plietar/solar-panel-monitor/hardware/power-monitor.kicad_pcb

## KiCad design hardware/power-monitor.kicad_pcb (2024-04-21)

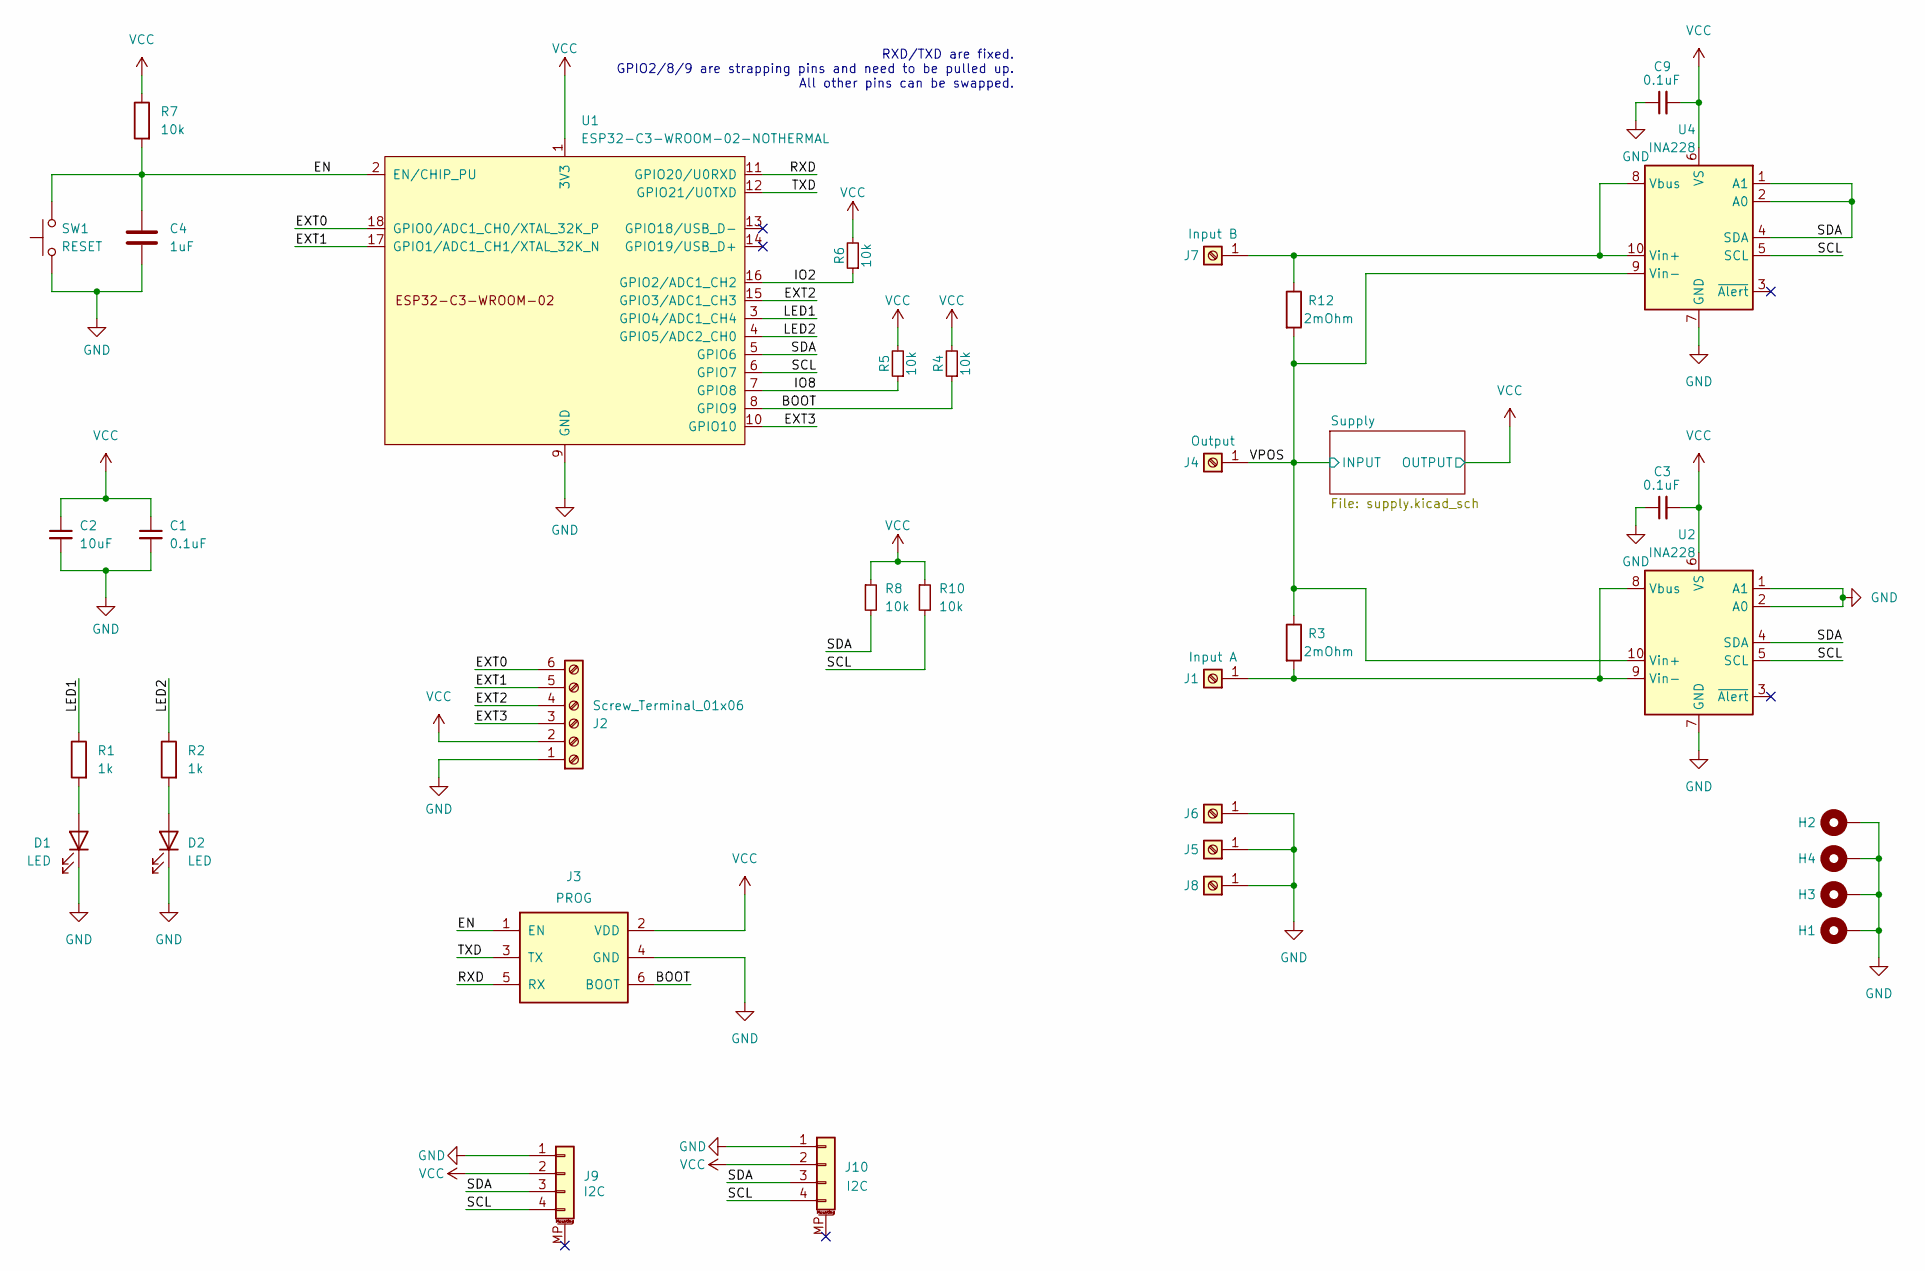
[picture p1: schematic power-monitor.kicad_sch]

Parts:
C1: 0.1uF; C_1206_3216Metric_Pad1.33x1.80mm_HandSolder
C2: 10uF; C_1206_3216Metric_Pad1.33x1.80mm_HandSolder
C3, C9: 0.1uF; C_0603_1608Metric_Pad1.08x0.95mm_HandSolder
C4: 1uF; C_1206_3216Metric_Pad1.33x1.80mm_HandSolder
D1, D2: LED; LED_1206_3216Metric_Pad1.42x1.75mm_HandSolder
H1, H2, H3, H4: MountingHole_Pad; MountingHole_2.2mm_M2_Pad
J1, J4, J5, J6, J7, J8: Wuerth_REDCUBE-THR_WP-THRSH_74651175_THR
J2: Screw_Terminal_01x06; TerminalBlock_Phoenix_MPT-0,5-6-2.54_1x06_P2.54mm_Horizontal
J3: Tag-Connect_TC2030-IDC-NL_2x03_P1.27mm_Vertical
J9: JST_PH_S4B-PH-SM4-TB_1x04-1MP_P2.00mm_Horizontal
J10: JST_SH_SM04B-SRSS-TB_1x04-1MP_P1.00mm_Horizontal
R1, R2: 1k; R_1206_3216Metric_Pad1.30x1.75mm_HandSolder
R3, R12: 2mOhm; R_2816_7142Metric_Pad3.20x4.45mm_HandSolder
R4, R5, R6, R7, R8, R10: 10k; R_1206_3216Metric_Pad1.30x1.75mm_HandSolder
SW1: RESET; SW_Push_1P1T_NO_6x6mm_H9.5mm
U1: ESP32-C3-WROOM-02-NOTHERMAL
U2, U4: INA228; VSSOP-10_3x3mm_P0.5mm

Connections:
/BOOT: J3.6 (BOOT), R4.1, U1.8 (GPIO9)
/EN: C4.1, J3.1 (EN), R7.2, SW1.1, U1.2 (EN/CHIP_PU)
/EXT0: J2.6, U1.18 (GPIO0/ADC1_CH0/XTAL_32K_P)
/EXT1: J2.5, U1.17 (GPIO1/ADC1_CH1/XTAL_32K_N)
/EXT2: J2.4, U1.15 (GPIO3/ADC1_CH3)
/EXT3: J2.3, U1.10 (GPIO10)
/IO2: R6.1, U1.16 (GPIO2/ADC1_CH2)
/IO8: R5.1, U1.7 (GPIO8)
/LED1: R1.1, U1.3 (GPIO4/ADC1_CH4)
/LED2: R2.1, U1.4 (GPIO5/ADC2_CH0)
/RXD: J3.5 (RX), U1.11 (GPIO20/U0RXD)
/SCL: J9.4, J10.4, R10.2, U1.6 (GPIO7), U2.5 (SCL), U4.5 (SCL)
/SDA: J9.3, J10.3, R8.2, U1.5 (GPIO6), U2.4 (SDA), U4.1 (A1), U4.2 (A0), U4.4 (SDA)
/TXD: J3.3 (TX), U1.12 (GPIO21/U0TXD)
/VPOS: J4.1, R3.1, R12.2, U2.10 (Vin+), U4.9 (Vin-); also elsewhere on the board
GND: C1.2, C2.2, C3.1, C4.2, C9.1, D1.1 (K), D2.1 (K), H1.1, H2.1, H3.1, H4.1, J2.1, J3.4 (GND), J5.1, J6.1, J8.1, J9.1, J10.1, SW1.2, U1.9 (GND), U2.1 (A1), U2.2 (A0), U2.7 (GND), U4.7 (GND); also elsewhere on the board
unnamed: D1.2 (A), R1.2
unnamed: D2.2 (A), R2.2
unnamed: J1.1, R3.2, U2.8 (Vbus), U2.9 (Vin-)
unnamed: J7.1, R12.1, U4.8 (Vbus), U4.10 (Vin+)
VCC: C1.1, C2.1, C3.2, C9.2, J2.2, J3.2 (VDD), J9.2, J10.2, R4.2, R5.2, R6.2, R7.1, R8.1, R10.1, U1.1 (3V3), U2.6 (VS), U4.6 (VS); also elsewhere on the board

Notes on the sheet:
RXD/TXD are fixed. GPIO2/8/9 are strapping pins and need to be pulled up. All other pins can be swapped.

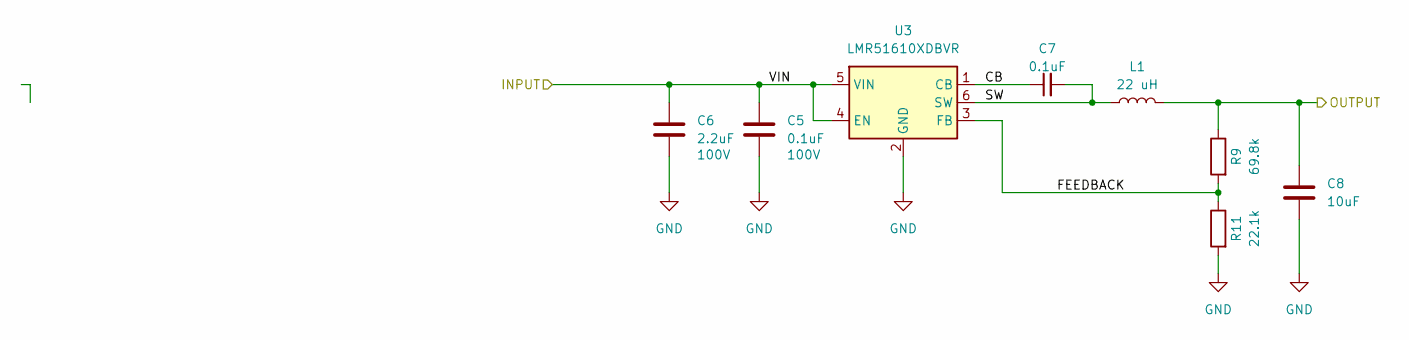
[picture p2: schematic supply.kicad_sch]

Parts:
C5, C7: 0.1uF; C_0603_1608Metric_Pad1.08x0.95mm_HandSolder
C6: 2.2uF; C_1206_3216Metric_Pad1.33x1.80mm_HandSolder
C8: 10uF; C_1206_3216Metric_Pad1.33x1.80mm_HandSolder
L1: 22 uH; L_Bourns_SRN6045TA
R9: 69.8k; R_1206_3216Metric_Pad1.30x1.75mm_HandSolder
R11: 22.1k; R_1206_3216Metric_Pad1.30x1.75mm_HandSolder
U3: LMR51610XDBVR; SOT-23-6

Connections:
/Supply/CB: C7.1, U3.1 (CB)
/Supply/FEEDBACK: R9.2, R11.1, U3.3 (FB)
/Supply/SW: C7.2, L1.1, U3.6 (SW)
/VPOS: C5.1, C6.1, U3.4 (EN), U3.5 (VIN); also elsewhere on the board
GND: C5.2, C6.2, C8.2, R11.2, U3.2 (GND); also elsewhere on the board
VCC: C8.1, L1.2, R9.1; also elsewhere on the board

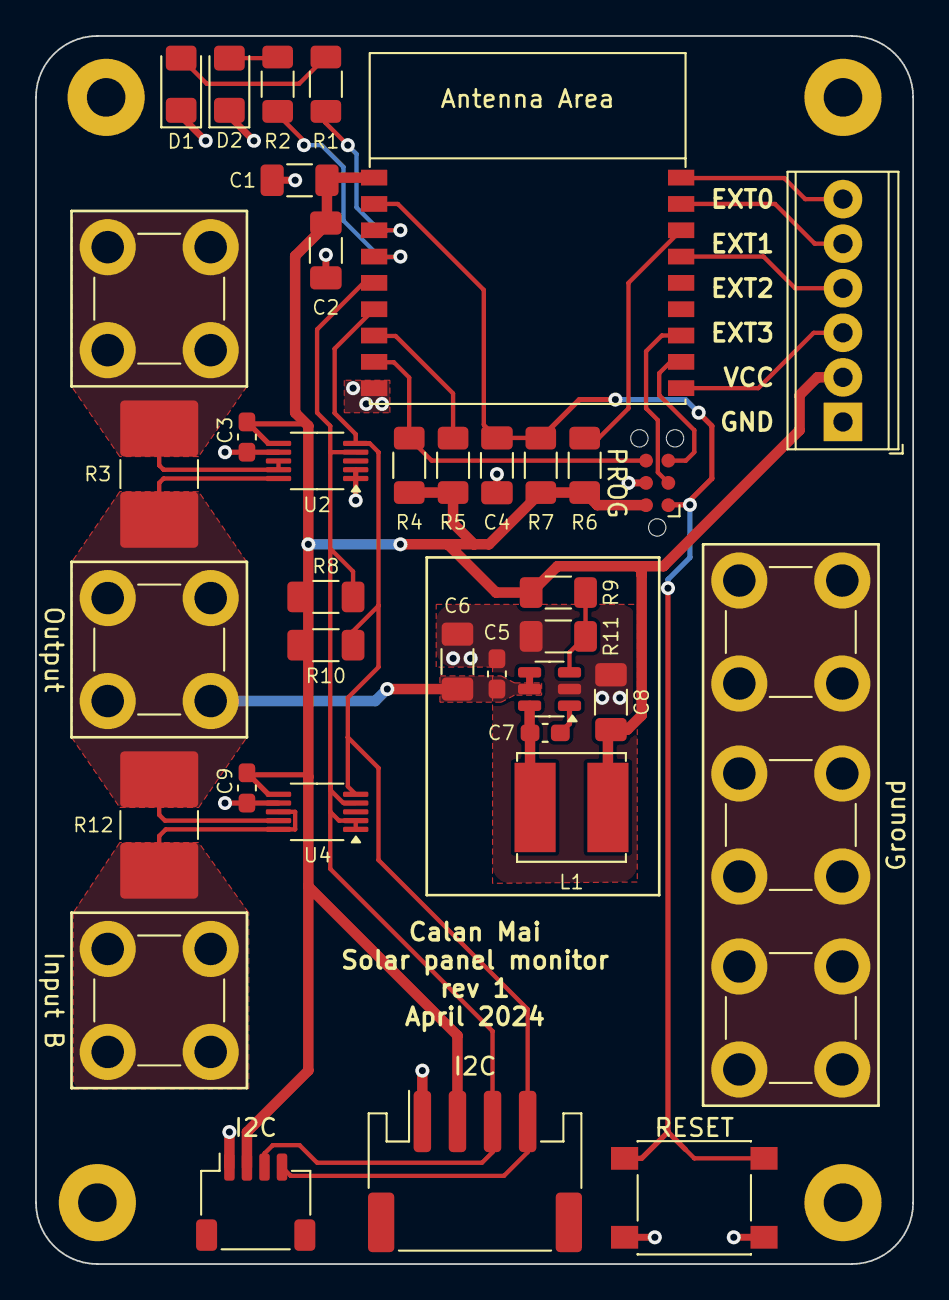
[picture p3: board power-monitor.kicad_pcb from above]

Board: 2 copper layers, 50.0 x 70.0 mm, 43 parts (0 on the bottom side), 24 nets.
