plietar/solar-panel-monitor/errata.txt

- Shunt resistor does not exist in 2816, use 2512 instead
- Button footprint is not quite right
- Stemma connector pin ordered is reversed
