plietar/solar-panel-monitor/(commit log)

2024-01-28 Start working on hardware
    [power-monitor.kicad_pcb, power-monitor.kicad_sch]
2024-02-02 PLC based hardware design
    [attiny.kicad_sch, esp32.kicad_sch, input.kicad_sch, plc.kicad_sch, power-monitor.kicad_pcb, power-monitor.kicad_sch, supply.kicad_sch]
2024-04-02 Remove PLC, use ESP
    [attiny.kicad_sch, esp32.kicad_sch, input.kicad_sch, plc.kicad_sch, power-monitor.kicad_pcb, power-monitor.kicad_sch, supply.kicad_sch]
2024-04-11 rev 1
    [input.kicad_sch, power-monitor.kicad_pcb, power-monitor.kicad_sch, supply.kicad_sch]
2024-04-21 Improve BOM
    [power-monitor.kicad_pcb, power-monitor.kicad_sch, supply.kicad_sch]
2024-04-21 Autoplace schematic labels.
    [power-monitor.kicad_sch, supply.kicad_sch]
2024-04-21 Publish interactive BOM to GitHub Pages.
